fuseoppl/PS2_keyboard_to_Amiga_CD32/KeyboardCD32_001.jpg

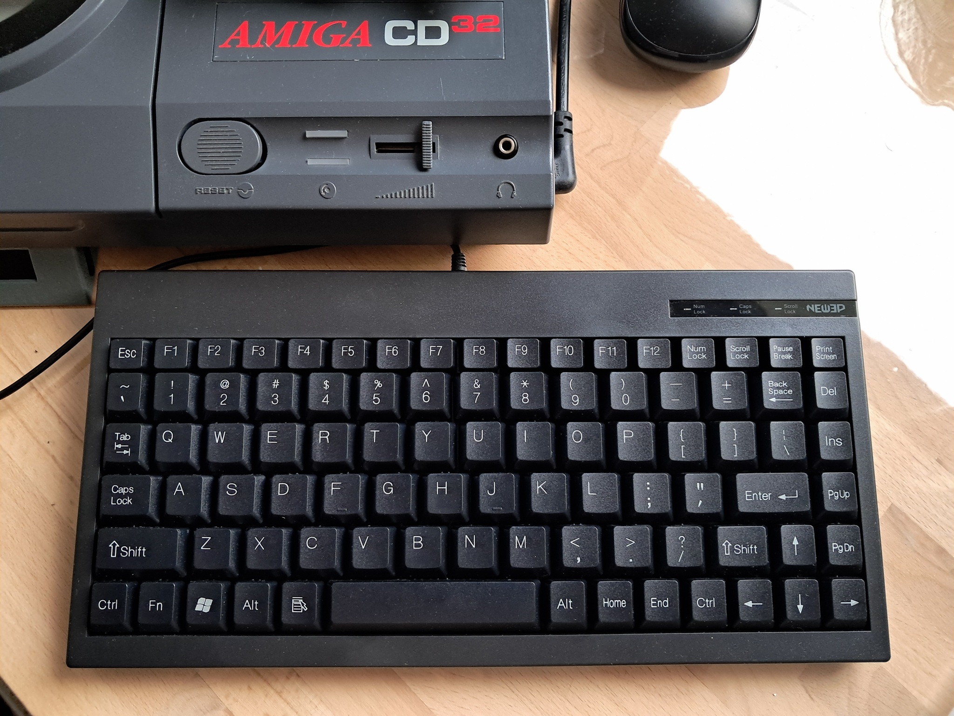
KeyboardCD32_001.jpg
