fuseoppl/PS2_keyboard_to_Amiga_CD32/(commit log)

2026-02-11 if defined - fix longer maxWaitForACK
    [PS2_keyboard_to_Amiga_CD32.ino]
2026-02-14 Clock timing correction (fixes a bug in some games)
    [PS2_keyboard_to_Amiga_CD32.ino]
2026-02-28 Detection of the duration of a keyboard clock line pull down by the Amiga, some games use a keyboard emulator that sends clock signals on the keyboard line, before this fix this caused the keyboard t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
    [PS2_keyboard_to_Amiga_CD32.ino]
2026-05-10 new Arduino board
2026-05-10 new keyboard wiring photo
